MuenningMachines/tf-silent-stepper-v2-bricklet/hardware/silent-stepper-v2.FCStd

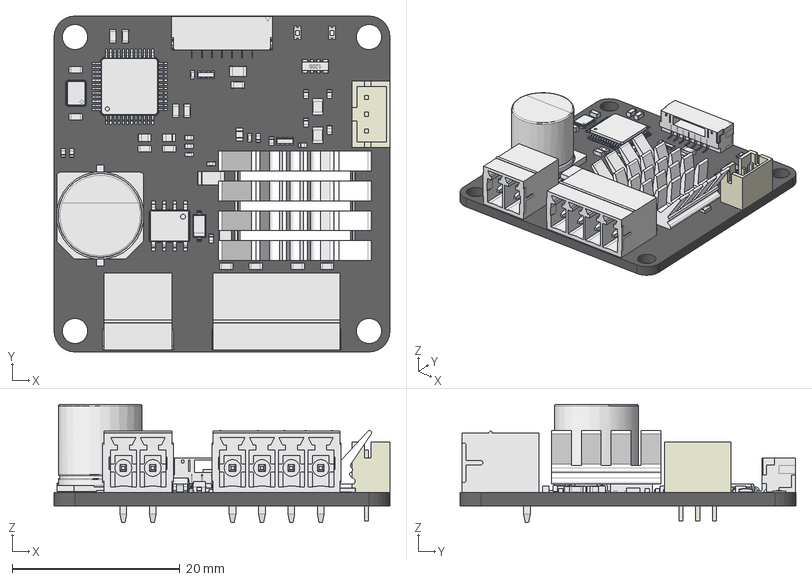
[picture p1: CAD file, 2021-04-28]
hardware/silent-stepper-v2.FCStd
40.0 x 40.0 x 14.1 mm
Pcb_609b
R18_R_0402_5F9829B7
R17_R_0402_5F98294B
R16_R_0402_5F982966
R1_R_0402_5F98299C
P6_B3B-PH-K-S_5F98B047
C30_C_0805_5F9829D2
C29_C_0805_5F982981
D3_Compound_5F92A2EE
C10_C_0402_5F92A1FB
D1_SOD-123_5F92A2CF
P5_4er_Phoenix_Buchse_5F92A326
R13_R_1206_5F92A3BC
R12_R_1206_5F92A3B2
R11_R_0402_5F92A3A8
R10_R_0402_5F92A39E
R9_R_0402_5F92A394
R8_R_0402_5F92A38A
R7_R_0402_5F92A380
R6_R_0402_5F92A376
R5_R_0603_5F92A36C
R4_R_0402_5F92A362
R3_R_0402_5F92A358
R2_R_0402_5F92A34E
C27_C_0402_5F92A2BB
C26_C_0402_5F92A2B1
C25_C_0603_5F92A2A7
C24_C_1206_5F92A29D
C23_C_0603_5F92A293
C22_C_0603_5F92A289
C21_C_0603_5F92A27F
C20_C_0603_5F92A275
C19_C_0603_5F92A26B
C18_C_0402_5F92A261
C17_C_0603_5F92A257
C16_C_0603_5F92A24D
C15_C_0603_5F92A243
C13_C_0603_5F92A224
C12_C_0402_5F92A21A
C1_C_0805_5F92A1A1
C2_C_0603_5F92A1AB
C3_C_0603_5F92A1B5
C4_C_0603_5F92A1BF
C5_C_0603_5F92A1C9
C6_C_0603_5F92A1D3
C7_C_0402_5F92A1DD
C8_C_0603_5F92A1E7
C9_C_0603_5F97FDEB
c_el_G_D100_L105
P1_BrickletConn_7pin_5F92A301
P4_2er_Phoenix_Buchse_Schwarz_5F92A31A
Q1_soic_8_39x49_p127_5F92A33A
RP1_Cut_5F92A3CC
RP2_Cut_5F92A3DC
U1_lqfp48_7x7_p05_5F92A41B
U6_dfn8_6x5_p127_5F92A487
U6_Kühlkörper_5F92A487[2]
X1_Compound_5F92A495
C14_C_0603_5F969241
C28_C_0603_5F96924B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
