MuenningMachines/tf-silent-stepper-v2-bricklet/hardware/silent-stepper-v2-schematic.pdf

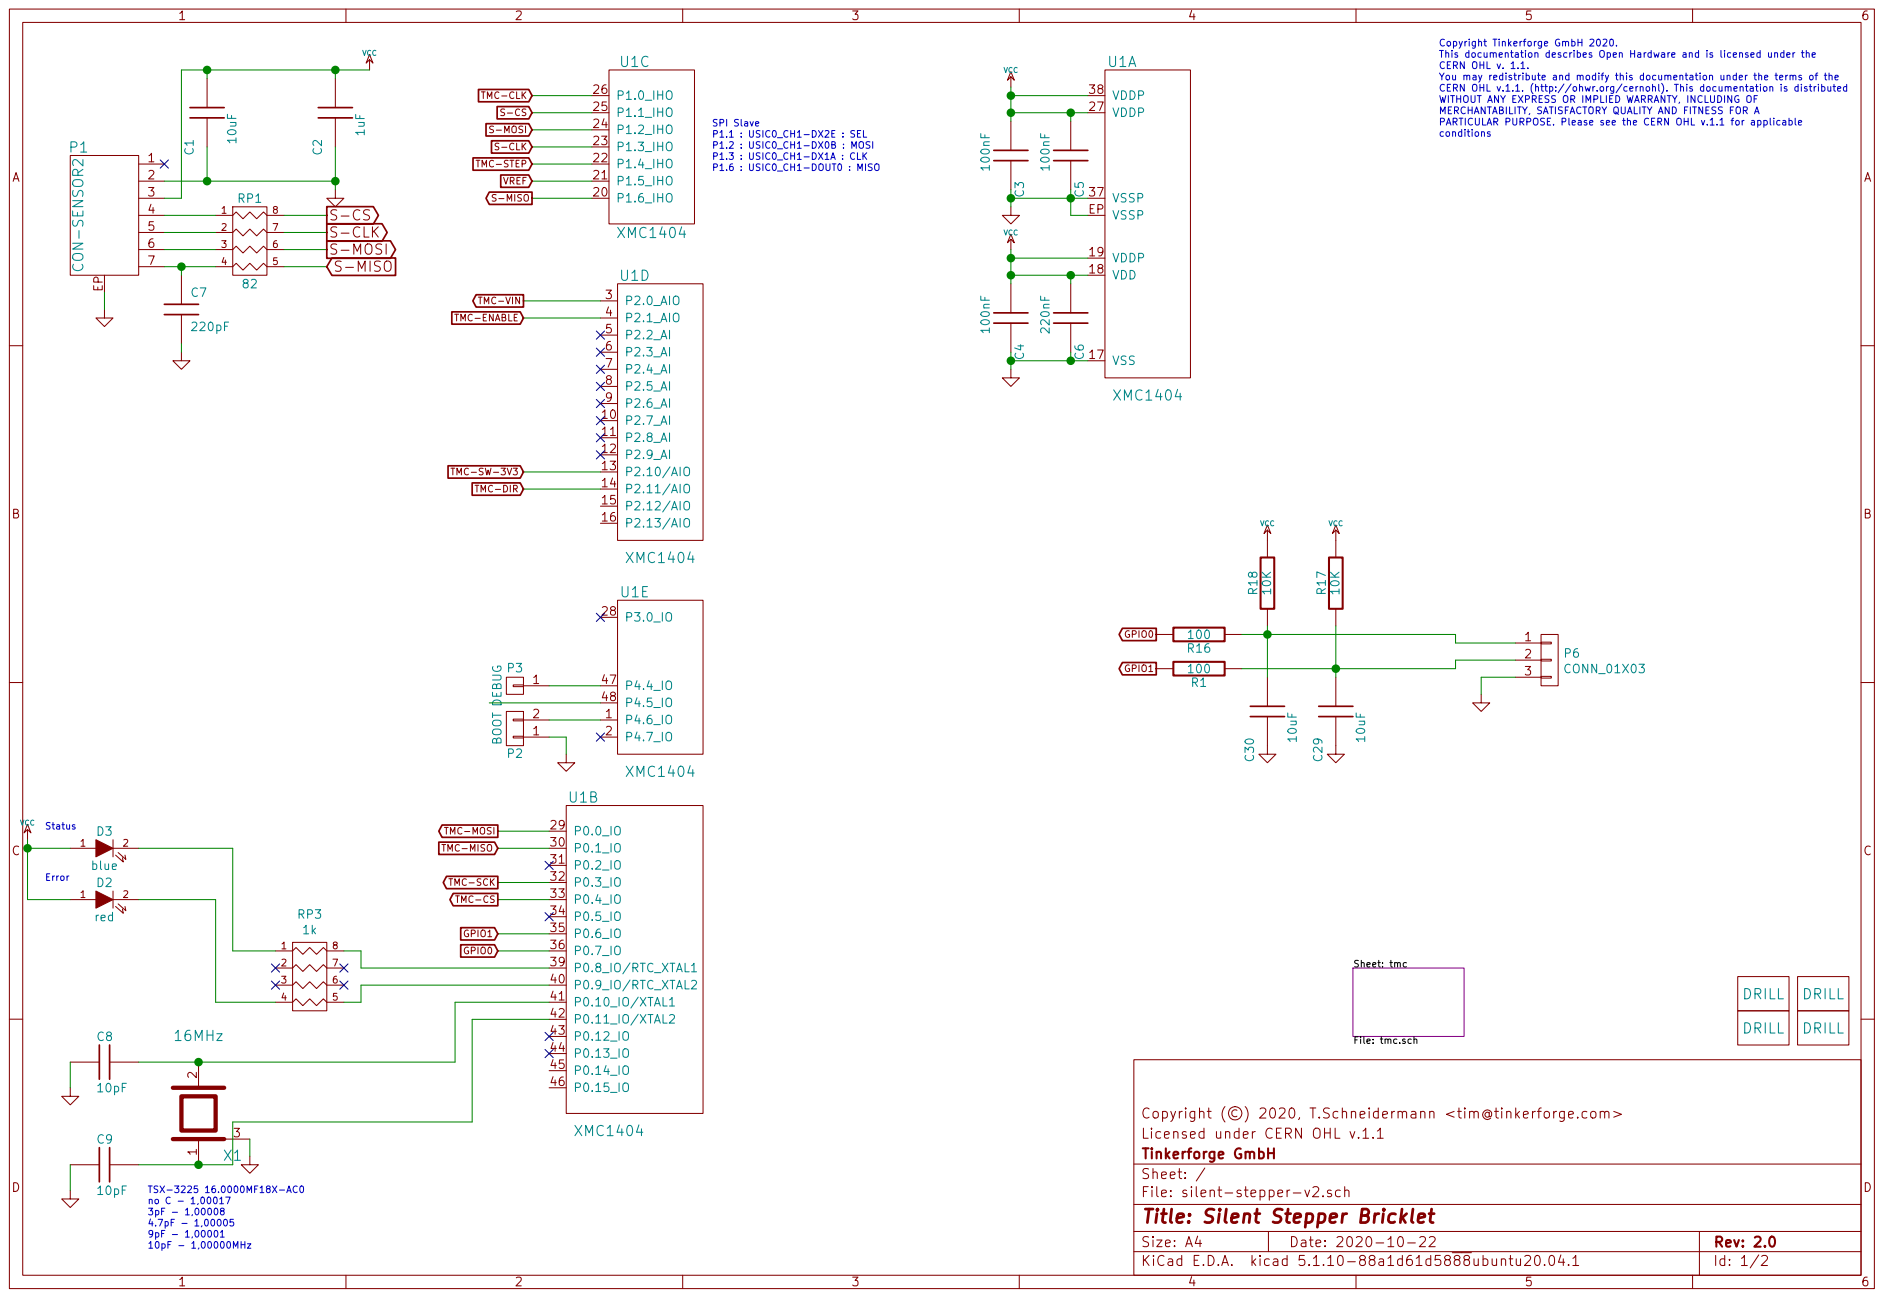
[picture p2: page 1]

TMC-SW-3V3 TMC-CLK
S-MOSI S-MISO
S-CLK
VCC TMC-STEP

conditions SPI Slave P1.1 : USIC0_CH1-DX2E : SEL P1.2 : USIC0_CH1-DX0B : MOSI P1.3 : USIC0_CH1-DX1A : CLK

PARTICULAR PURPOSE. Please see the CERN OHL v.1.1 for applicable

TMC-MOSI TMC-MISO

Sheet: tmc File: tmc.sch

Licensed under CERN OHL v.1.1 Copyright (©) 2020, T.Schneidermann <tim@tinkerforge.com>

File: silent-stepper-v2.sch Sheet: / Tinkerforge GmbH

Id: 1/2 Title: Silent Stepper Bricklet

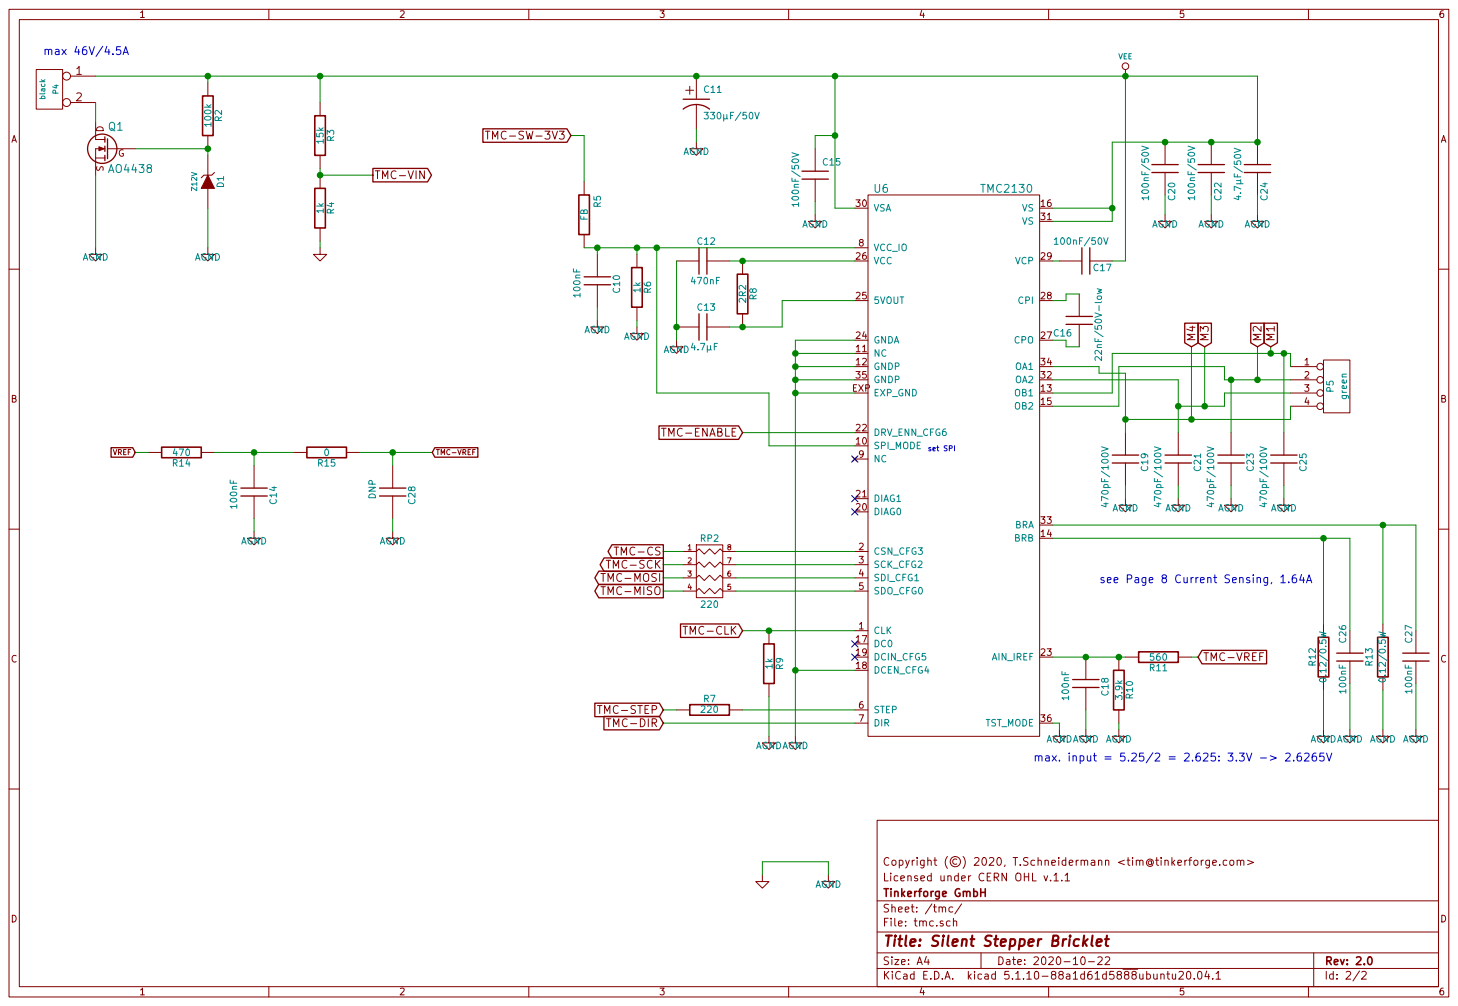
[picture p3: page 2]

see Page 8 Current Sensing, 1.64A

Id: 2/2 Title: Silent Stepper Bricklet File: tmc.sch Sheet: /tmc/ Tinkerforge GmbH
