MuenningMachines/tf-silent-stepper-v2-bricklet/software/src/stepper.h

/* silent-stepper-v2-bricklet
 * Copyright (C) 2020 Olaf Lüke <olaf@tinkerforge.com>
 *
 * stepper.h: Driver for stepper motion
 *
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
 * You should have received a copy of the GNU Lesser General Public
 * License along with this library; if not, write to the
 * Free Software Foundation, Inc., 59 Temple Place - Suite 330,
 * Boston, MA 02111-1307, USA.
 */

#ifndef STEPPER_H
#define STEPPER_H

#include <stdint.h>
#include <stdbool.h>

#define STEPPER_VREF_MIN_CURRENT 360
#define STEPPER_VREF_MAX_CURRENT 1640

#define STEPPER_VELOCITY_DEFAULT           500
#define STEPPER_ACCELERATION_DEFAULT       1000
#define STEPPER_ACCELERATION_SQRT_DEFAULT  31 // sqrt(1000)
#define STEPPER_DECELERATION_DEFAUL        1000
#define STEPPER_MINIMUM_VOLTAGE_DEFAULT    8000
#define STEPPER_VOLTAGE_EPSILON            6000
#define STEPPER_OUTPUT_CURRENT_DEFAULT     800

#define STEPPER_VELOCITY_TO_DELAY(vel) ((2147483647/2)/(vel))
#define STEPPER_DELAY_TO_VELOCITY(del) ((2147483647/2)/(del))

#define STEPPER_MAX_TIMER_VALUE 0xFFFF

#define STEPPER_READ_REGISTER_PERIOD 10 // ms


#define STEPPER_STATE_OFF    1
#define STEPPER_STATE_STOP   2
#define STEPPER_STATE_DRIVE  3
#define STEPPER_STATE_STEPS  4
#define STEPPER_STATE_TARGET 5

// Define forward and backward same as for direction,
// this allows for easy comparisons
#define STEPPER_SPEEDRAMP_STATE_FORWARD        1
#define STEPPER_SPEEDRAMP_STATE_BACKWARD      -1
#define STEPPER_SPEEDRAMP_STATE_STOP           2
#define STEPPER_SPEEDRAMP_STATE_ACCELERATION   3
#define STEPPER_SPEEDRAMP_STATE_RUN            4
#define STEPPER_SPEEDRAMP_STATE_DECELERATION   5

#define STEPPER_DIRECTION_FORWARD   1
#define STEPPER_DIRECTION_BACKWARD -1

#define STEPPER_API_STATE_STOP 1
#define STEPPER_API_STATE_ACCELERATION 2
#define STEPPER_API_STATE_RUN 3
#define STEPPER_API_STATE_DECELERATION 4
#define STEPPER_API_STATE_DIR_CHANGE_FORWARD 5
#define STEPPER_API_STATE_DIR_CHANGE_BACKWARD 6

typedef struct {
	uint32_t velocity_goal;
	uint32_t velocity;
	uint16_t acceleration;
	uint16_t acceleration_sqrt;
	uint16_t deceleration;
	uint16_t minimum_voltage;

	int32_t position;
	int32_t target_position;
	int32_t steps;
	uint16_t output_current;
	int8_t state;
	int8_t speedramp_state;
	int8_t direction;

	int32_t step_counter;
	int32_t acceleration_counter;
	uint32_t acceleration_steps;
	int32_t deceleration_steps;
	int32_t delay;
	int32_t last_delay;
	int32_t delay_rest;
	int32_t deceleration_start;
	uint32_t tick_counter;
	uint8_t tick_read_counter;

	uint32_t time_base;
	uint32_t time_base_counter;
	uint32_t all_data_period;

	bool running;
	bool position_reached;

	bool minimum_voltage_cb_done;

	uint8_t api_state;
	uint8_t api_prev_state;
	bool api_state_send;

	bool silent_mode_switched;
	bool motor_stalled_enabled;
} Stepper;

extern Stepper stepper;

void stepper_tick(void);
void stepper_init(void);

void stepper_reset(void);
void stepper_set_step_mode(const uint8_t mode);
uint8_t stepper_get_step_mode(void);
void stepper_stop(void);
void stepper_set_decay(const uint16_t decay);
void stepper_enable(void);
void stepper_disable(void);
void stepper_update_tc_frequency(void);
void stepper_set_direction(const int8_t direction);
void stepper_position_reached_signal(void);
bool stepper_is_currently_running(void);
void stepper_set_next_timer(const uint32_t velocity);
void stepper_make_step(void);
void stepper_make_step_speedramp(const int32_t steps);
void stepper_step_speedramp(void);
void stepper_make_drive_speedramp(const uint8_t state);
void stepper_drive_speedramp(void);
void stepper_full_brake(void);
void stepper_check_error_signals(void);
void stepper_set_sync_rect(bool sr);
int32_t stepper_get_remaining_steps(void);
void stepper_all_data_signal(void);
void stepper_state_signal(void);
void stepper_set_new_api_state(const uint8_t new_state);

#endif
