MuenningMachines/tf-silent-stepper-v2-bricklet/(commit log)

2020-10-23 initial push
    [silent-stepper-v2.kicad_pcb, silent-stepper-v2.sch, tmc.sch]
2020-10-26 schematics updated
    [silent-stepper-v2.sch, tmc.sch]
2020-10-27 pcb design
    [silent-stepper-v2.kicad_pcb, silent-stepper-v2.sch, tmc.sch]
2020-10-28 changed pinout for better groundplane routing
    [silent-stepper-v2.kicad_pcb, silent-stepper-v2.sch]
2020-11-09 fixed silkscreen
    [silent-stepper-v2.kicad_pcb, silent-stepper-v2.sch]
2020-11-27 Add Silent Stepper Bricklet 2.0 firmware
    [cmake_config_custom.txt]
2020-12-02 Don't call irq handler direcly
    Instead we start the next timer which will create an actual IRQ
2020-12-02 Increase task stack size to 4096 und make sure there is no reentrance race condition for division in IRQ
2020-12-02 Improve gpio_check performance for normal case (no change)
2020-12-02 Remove stepper tick task
    Voltage check is done in TMC2130 tick task instead.
2020-12-02 Improve stepper speedramping performance
2020-12-02 Add Error LED support
    [communication.c, communication.h, tmc2130.c]
2021-01-11 fix rc network values
    [silent-stepper-v2.kicad_pcb, tmc.sch]
2021-04-28 fix 3d, add schematic
    [silent-stepper-v2.kicad_pcb, silent-stepper-v2.sch]
2021-04-28 add 3d data
    [silent-stepper-v2.FCStd]
2021-05-03 Add examples
    [ExampleConfiguration.nb.txt, example-configuration.txt]
2021-05-04 examples: Fix user data passing to callback
    [example_callback.c]
2021-05-04 examples: Add missing imports
    [ExampleCallback.java]
2021-10-25 Update KiCad link
    https://www.kicad.org/blog/2021/10/Avoid-links-to-former-kicad-domain/
2022-04-08 Fix bug in AllData-Callback period handling
    [communication.c]
2022-04-26 uc: Adapt to bindings changes
    [example_callback.c, example_configuration.c]
2024-02-21 examples/rust: Fix random number generation.
    [example_callback.rs]
2025-02-13 Add MotorStalled-Callback
