MuenningMachines/tf-silent-stepper-v2-bricklet/(notices)

Notices in the files:
hardware/silent-stepper-v2.kicad_pcb:
Copyright Tinkerforge GmbH 2020.
This documentation describes Open Hardware and is licensed under the
CERN OHL v. 1.1.
